jkfritcher/ps1_md_cart/genesis_phantasy_star_cart.kicad_pcb

## KiCad design genesis_phantasy_star_cart.kicad_pcb (2024-09-26)

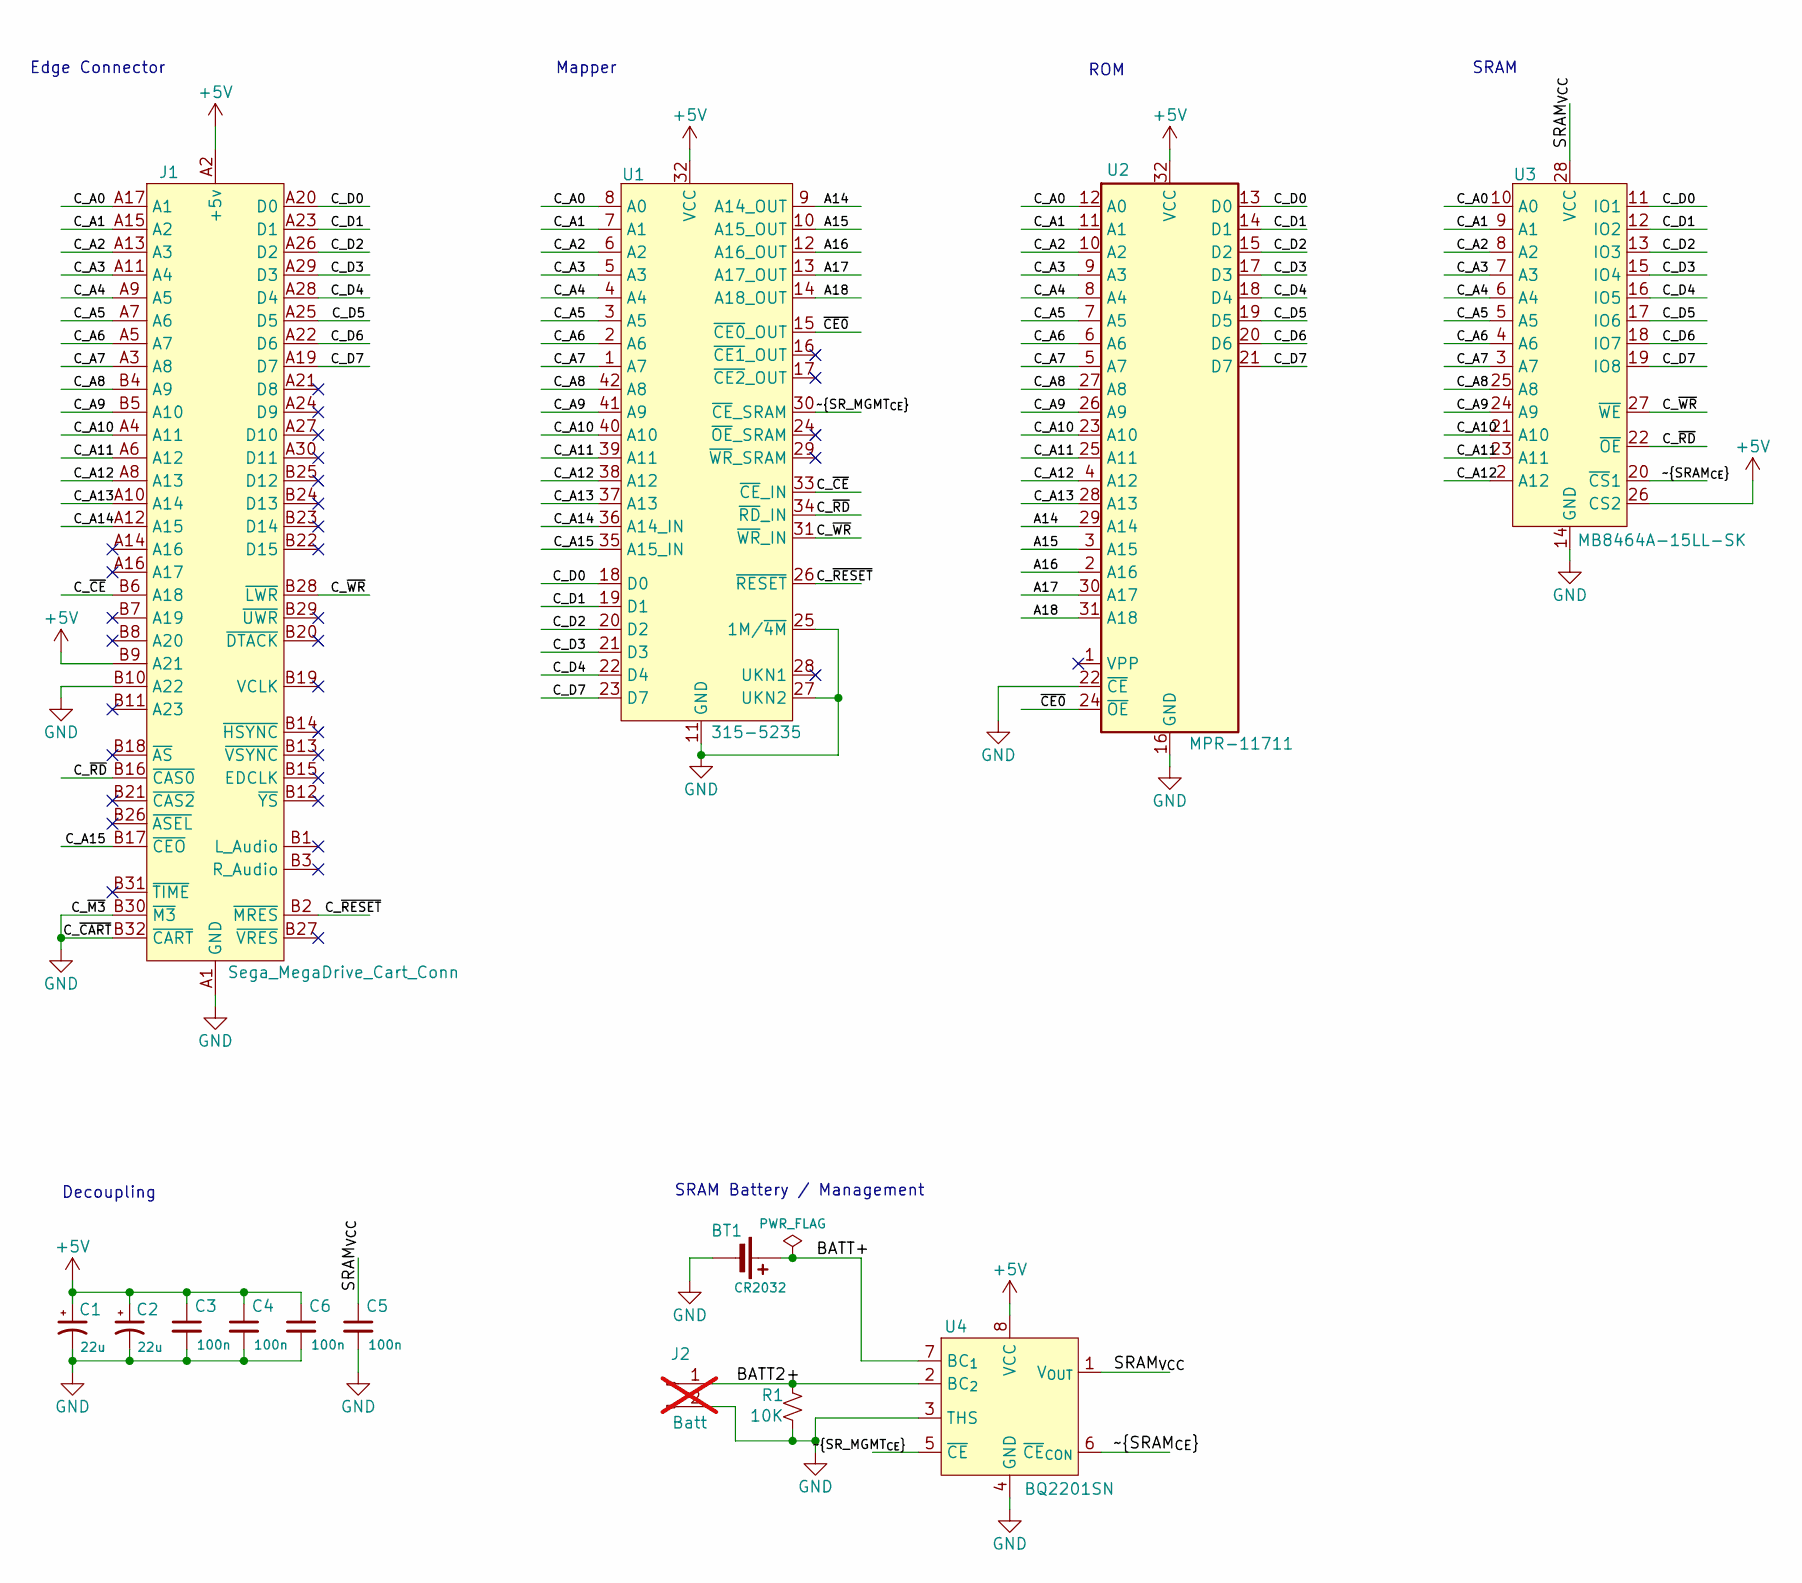
[picture p1: schematic genesis_phantasy_star_cart.kicad_sch]

Parts:
BT1: CR2032; CR2032L-F1N
C1, C2: 22u; CP_Elec_4x5.4
C3, C4, C5, C6: 100n; C_0603_1608Metric
J1: Sega_MegaDrive_Cart_Conn; 2x32_P2.54mm_Edge
J2: Batt; PinHeader_1x02_P2.54mm_Vertical; not fitted
R1: 10K; R_0603_1608Metric
U1: 315-5235; SPDIP-42_W15.24mm_P1.78mm
U2: MPR-11711; DIP-32_W15.24mm_LongPads
U3: MB8464A-15LL-SK; DIP-28_W7.62mm_LongPads
U4: BQ2201SN; SOIC-8_3.9x4.9mm_P1.27mm

Connections:
+5V: C1.1, C2.1, C3.1, C4.1, C6.1, J1.A2 (+5v), J1.A31 (+5v), J1.B9 (A21), U1.32 (VCC), U2.32 (VCC), U3.26 (CS2), U4.8 (VCC)
/A14: U1.9 (A14_OUT), U2.29 (A14)
/A15: U1.10 (A15_OUT), U2.3 (A15)
/A16: U1.12 (A16_OUT), U2.2 (A16)
/A17: U1.13 (A17_OUT), U2.30 (A17)
/A18: U1.14 (A18_OUT), U2.31 (A18)
/BATT2+: J2.1, R1.1, U4.2 (BC_{2})
/BATT+: BT1.1 (+), U4.7 (BC_{1})
/C_A0: J1.A17 (A1), U1.8 (A0), U2.12 (A0), U3.10 (A0)
/C_A1: J1.A15 (A2), U1.7 (A1), U2.11 (A1), U3.9 (A1)
/C_A2: J1.A13 (A3), U1.6 (A2), U2.10 (A2), U3.8 (A2)
/C_A3: J1.A11 (A4), U1.5 (A3), U2.9 (A3), U3.7 (A3)
/C_A4: J1.A9 (A5), U1.4 (A4), U2.8 (A4), U3.6 (A4)
/C_A5: J1.A7 (A6), U1.3 (A5), U2.7 (A5), U3.5 (A5)
/C_A6: J1.A5 (A7), U1.2 (A6), U2.6 (A6), U3.4 (A6)
/C_A7: J1.A3 (A8), U1.1 (A7), U2.5 (A7), U3.3 (A7)
/C_A8: J1.B4 (A9), U1.42 (A8), U2.27 (A8), U3.25 (A8)
/C_A9: J1.B5 (A10), U1.41 (A9), U2.26 (A9), U3.24 (A9)
/C_A10: J1.A4 (A11), U1.40 (A10), U2.23 (A10), U3.21 (A10)
/C_A11: J1.A6 (A12), U1.39 (A11), U2.25 (A11), U3.23 (A11)
/C_A12: J1.A8 (A13), U1.38 (A12), U2.4 (A12), U3.2 (A12)
/C_A13: J1.A10 (A14), U1.37 (A13), U2.28 (A13)
/C_A14: J1.A12 (A15), U1.36 (A14_IN)
/C_A15: J1.B17 (~CEO), U1.35 (A15_IN)
/C_D0: J1.A20 (D0), U1.18 (D0), U2.13 (D0), U3.11 (IO1)
/C_D1: J1.A23 (D1), U1.19 (D1), U2.14 (D1), U3.12 (IO2)
/C_D2: J1.A26 (D2), U1.20 (D2), U2.15 (D2), U3.13 (IO3)
/C_D3: J1.A29 (D3), U1.21 (D3), U2.17 (D3), U3.15 (IO4)
/C_D4: J1.A28 (D4), U1.22 (D4), U2.18 (D4), U3.16 (IO5)
/C_D5: J1.A25 (D5), U2.19 (D5), U3.17 (IO6)
/C_D6: J1.A22 (D6), U2.20 (D6), U3.18 (IO7)
/C_D7: J1.A19 (D7), U1.23 (D7), U2.21 (D7), U3.19 (IO8)
/C_~CE: J1.B6 (A18), U1.33 (~CE_IN)
/C_~RD: J1.B16 (~CAS0), U1.34 (~RD_IN), U3.22 (~OE)
/C_~RESET: J1.B2 (~MRES), U1.26 (~RESET)
/C_~WR: J1.B28 (~LWR), U1.31 (~WR_IN), U3.27 (~WE)
/SRAM_{VCC}: C5.1, U3.28 (VCC), U4.1 (V_{OUT})
/~CE0: U1.15 (~CE0_OUT), U2.24 (~OE)
/~SRAM_{CE}: U3.20 (~CS1), U4.6 (~CE_{CON})
/~SR_MGMT_{CE}: U1.30 (~CE_SRAM), U4.5 (~CE)
GND: BT1.2 (-), C1.2, C2.2, C3.2, C4.2, C5.2, C6.2, J1.A1 (GND), J1.A18 (GND), J1.A32 (GND), J1.B10 (A22), J1.B30 (~M3), J1.B32 (~CART), J2.2, R1.2, U1.11 (GND), U1.25 (1M/~4M), U1.27 (UKN2), U2.16 (GND), U2.22 (~CE), U3.14 (GND), U4.3 (THS), U4.4 (GND)

Notes on the sheet:
Decoupling
Mapper
Edge Connector
SRAM
ROM
SRAM Battery / Management

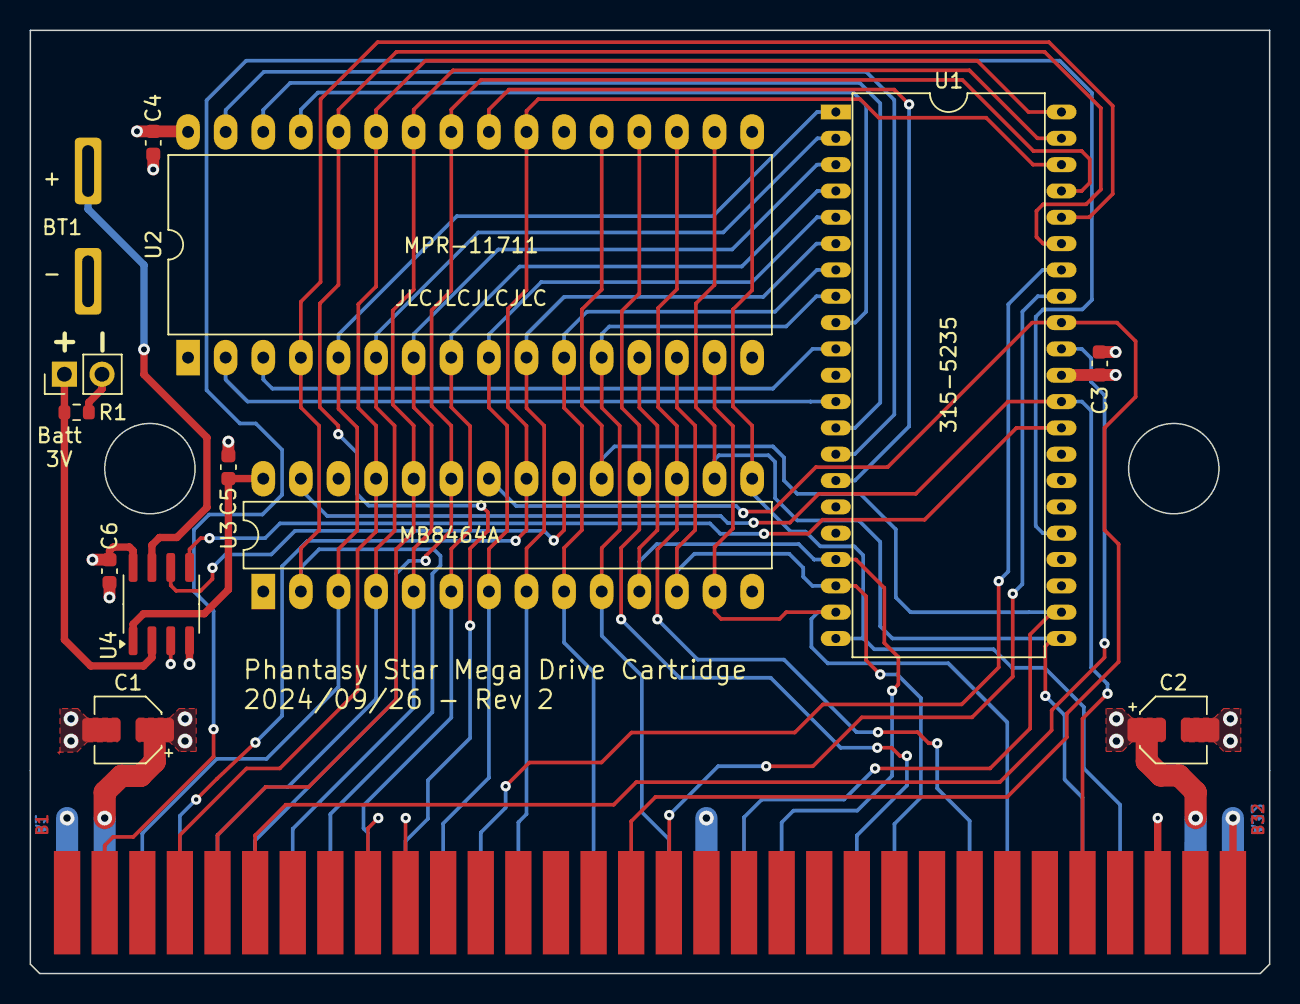
[picture p2: board genesis_phantasy_star_cart.kicad_pcb from above]

Board: 4 copper layers, 83.7 x 63.7 mm, 14 parts (1 on the bottom side), 41 nets.
