jkfritcher/ps1_md_cart/(commit log)

2024-07-11 PS1 MD Cartridge Rev 1
    First revision of the Phantasy Star Mega Drive cartridge. This rev has
    been sent for printing to test the basic functionality before final
    design work is complete.
    Following changes are still needed before being complete.
    * Layout and footprint for CR2032 is needed. Currently has 2 pin headers
    to attach a battery for testing.
    * The footprint in the library for the cartridge slot needs to be corrected
    to actually match the footprint that is in the PCB design.
    * Incorporating any changes needed from first round testing.
    [genesis_phantasy_star_cart.kicad_pcb, genesis_phantasy_star_cart.kicad_sch]
2024-07-18 Add 3d model for mapper
    * Added 3D model for the U1 mapper chip
    * Added an extra +5v and GND via to C1 and C2.
    [genesis_phantasy_star_cart.kicad_pcb, genesis_phantasy_star_cart.kicad_sch]
2024-07-18 Rename mapper footprint and model
    * Renamed footprint and model for mapper to be more accurate and with
    the dimentions in metric.
    [genesis_phantasy_star_cart.kicad_pcb, genesis_phantasy_star_cart.kicad_sch]
2024-09-22 Changes leading to Rev 2 of the board
    * Trimmed wings off of the edges of the board to make it a regular
    shape.
    * Slightly moved around U1/2/3 to make more room around the cutouts.
    * Moved backup battery connection, but remains pin headers as a CR2032
    footprint won't fit on the board with the ICs where they are.
    * Enlarged drill size for U1 pads to allow the pins to fit easier.
    * Various tracks nudged or rerouted to create more clearance.
    [genesis_phantasy_star_cart.kicad_pcb, genesis_phantasy_star_cart.kicad_sch]
2024-09-25 Add NPTH for potential use by battery wires
    * Added NPTH for battery wires to use for front soldering. Possible
    stress relief for the wires.
    * Rotated battery pin headers to orient better with NPTH.
    [genesis_phantasy_star_cart.kicad_pcb]
2024-09-26 Convert backup battery to proper footprint
    * Backup battery is now using a proper footprint for a CR2032 with
    solder tabs. Kapton tape will be needed between battery and pins on
    the backside of the board.
    * Converted battery pin header to be a secondary battery to
    maintain the SRAM while changing the primary battery. Added a pulldown
    to this to keep the supervisor happy while the seconary is not
    connected.
    [genesis_phantasy_star_cart.kicad_pcb, genesis_phantasy_star_cart.kicad_sch]
